AndHoratiu/proiect-scia/README.md

Analog Signal Processing System
General Description:
This project focuses on the design, simulation, and physical implementation of a complex electronic system intended for analog signal conditioning. The system is structured into four functional stages built using OP482 precision operational amplifiers.
System Architecture:
Stage 1: Inverting Amplifier with DC Compensation – Provides a linear gain of 7 and allows DC offset voltage adjustment via a potentiometer.
Stage 2: Sallen-Key Band-Pass Filter – Designed for a center frequency of 1 kHz, with a quality factor Q.
Stage 3: Programmable Gain Amplifier (PGA) – Allows gain adjustment between -1 dB and 8 dB (3 dB resolution) via analog switches.
Stage 4: Negative Peak Detector – A precision rectifier configuration with a linear gain of 1 used to extract the minimum value of the signal.
