AndHoratiu/proiect-scia/PROIECT SCIA.pdf

Instituția: Universitatea Tehnică Din Cluj Napoca
Facultatea: Facultatea de Electronică, Telecomunicații și Tehnologia Informației Disciplina: Sisteme cu Circuite Integrate Analogice (SCIA)

## PROIECT SCIA

Student: ANDRONE HORAȚIU GLIGOR

## TEMATICA PROIECTULUI

Proiect are ca scop realizarea și analiza unui sistem electronic bazat pe sisteme cu circuite integrate analogice (SCIA), destinat prelucrării unui semnal electric analogic, utilizând amplificatoare operaționale și circuite electronice.

Sistemul este structurat în patru etaje funcționale, realizate cu amplificatoare operaționale, fiecare având parametri electrici specifici. Proiectul analizează etapele de prelucrare a semnalului analogic, incluzând condiționarea, filtrarea activă, amplificarea cu câștig selectabil și redresarea de precizie, evidențiind rolul circuitelor
integrate | analogice | în | aplicațiile | de | prelucrare | a | semnalelor.

Specificații generale

- Sursa de semnal – single ended
- Amplitudine minimă: 199mV
- Amplitudine maximă: 561mV

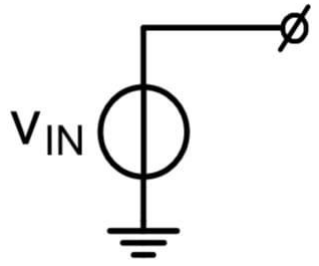
[picture p1: figure]

- Etaj 1: AO + compensare DC V-V – Amplificator inversor
- Căștig liniar: 7
- Rin_min: 1 kOhm
- Reglaj Out_DC: DA

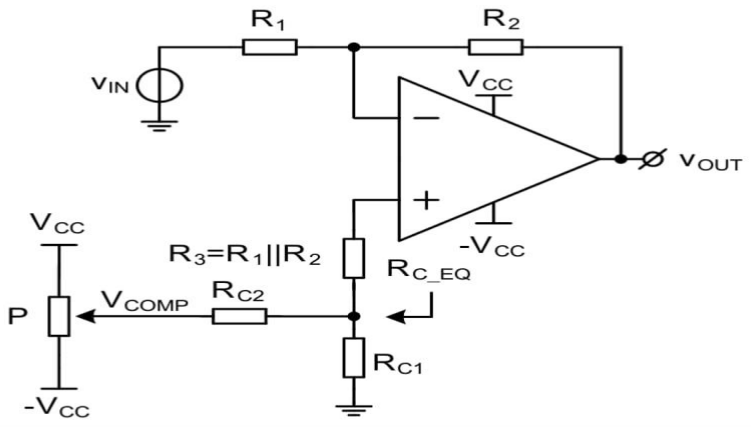
[picture p2: figure]

- Etaj 2: Filtru Trece-Banda Sallen-Key
- Câștig liniar: 1
- Rin_min: 750 ohm
- Banda: 1 kHz
- Q: 0,707

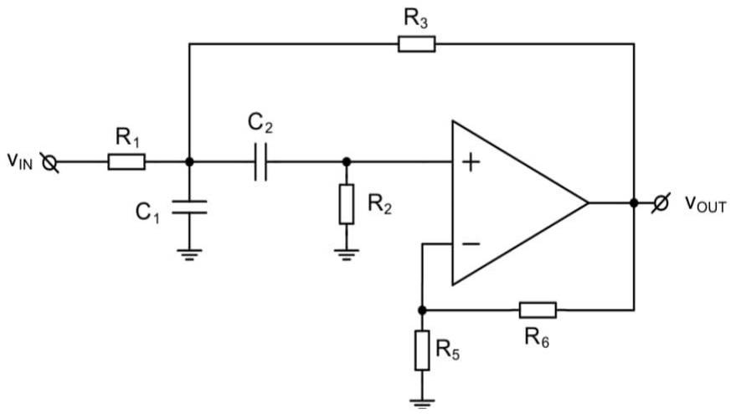
[picture p3: figure]

- Etaj 3: Amplificator cu câștig reglabil prin comutatoare
- Câștig minim: -1 dB
- Rezoluție: 3dB
- Număr pași: 4
- Câștig maxim: 8 dB
- Rin_min: 3 kOhm

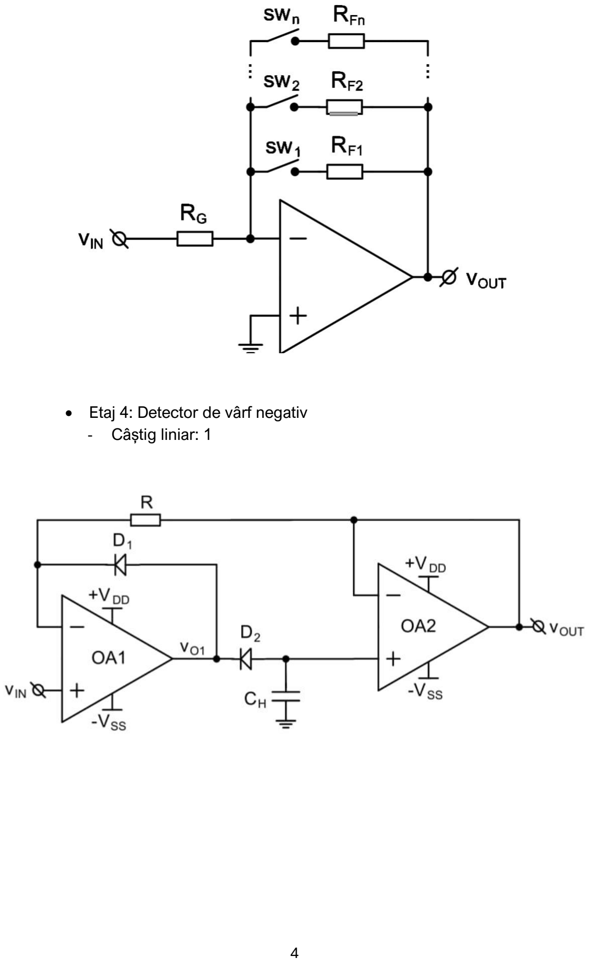
[picture p4: page 4]

- Etaj 4: Detector de vârf negativ
- Câștig liniar: 1

- Amplificator operational: OP482

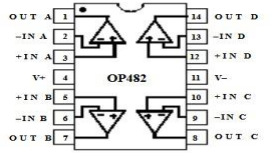
[picture p5: figure]

https://www.alldatasheet.com/html-pdf/49049/AD/OP482/43/2/OP482.html

## Dimensionarea etajelor

- Etaj 1 – dimensionare:

Av = −

R2
R1

= 7

R1 = 10kΩ

R2 = |Av

| ⋅ R1 = 7 ⋅ 10kΩ = 70kΩ

R3 = R1 ∥ R2 =

R1

⋅ R2
R1 + R2

= 8,75kΩ

V+ = VCOMP ⋅

RC1
RC1 + RC2

Vout = −

R2
R1

⋅ Vin + (1 +

R2
R1

) ⋅ V +

⇒ RC1 = 1kΩ RC2 = 220kΩ

- Etaj 2 – dimensionare:

Conform:

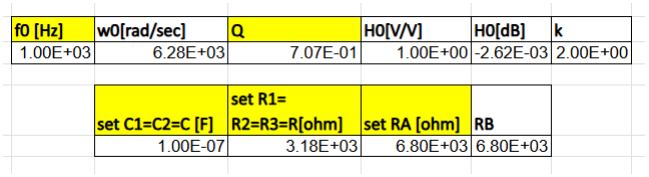
[picture p6: figure]

HBP =

VoutBP
Vin =

(s ⋅ wz)
s

2 + s ⋅

wp
Q

⋅ wp

2

R1 = R2 = R3 = 3,18kΩ

RA = RB = 6,8kΩ

- Etaj 3 – dimensionare:
SW 1 | SW 2 | SW3 | SW 4 | RG | RF | AV_liniar
1 | 0 | 0 | 0 | RG | R4 | 0,891
0 | 1 | 0 | 0 | RG | R3 | 1,259
0 | 0 | 1 | 0 | RG | R2 | 1,778
0 | 0 | 0 | 1 | RG | R1 | 2,512

AdB = [−1, 2, 5, 8]

AVliniar = 10

AdB
20

AV =

RG
RF

⇒ RF = AV ⋅ RG

Aleg RG = 3,3kΩ

RF1 = 2,94kΩ | RF2 = 4,15kΩ | RF3 = 5,67kΩ | RF4 = 8,29kΩ
- Etaj 4 – dimensionare:

Vin > 0 ⇒ VOA1 ↑ VDD ⇒ D1 ON, D2 OFF ⇒ VO = −

R2
R1

⋅ Vin
Vin < 0 ⇒ VOA2 ↓ − VSS ⇒ D1 OFF, D2 ON ⇒ VO = Vin

R = 10kΩ C = 100nF

## Caracterizare etajelor

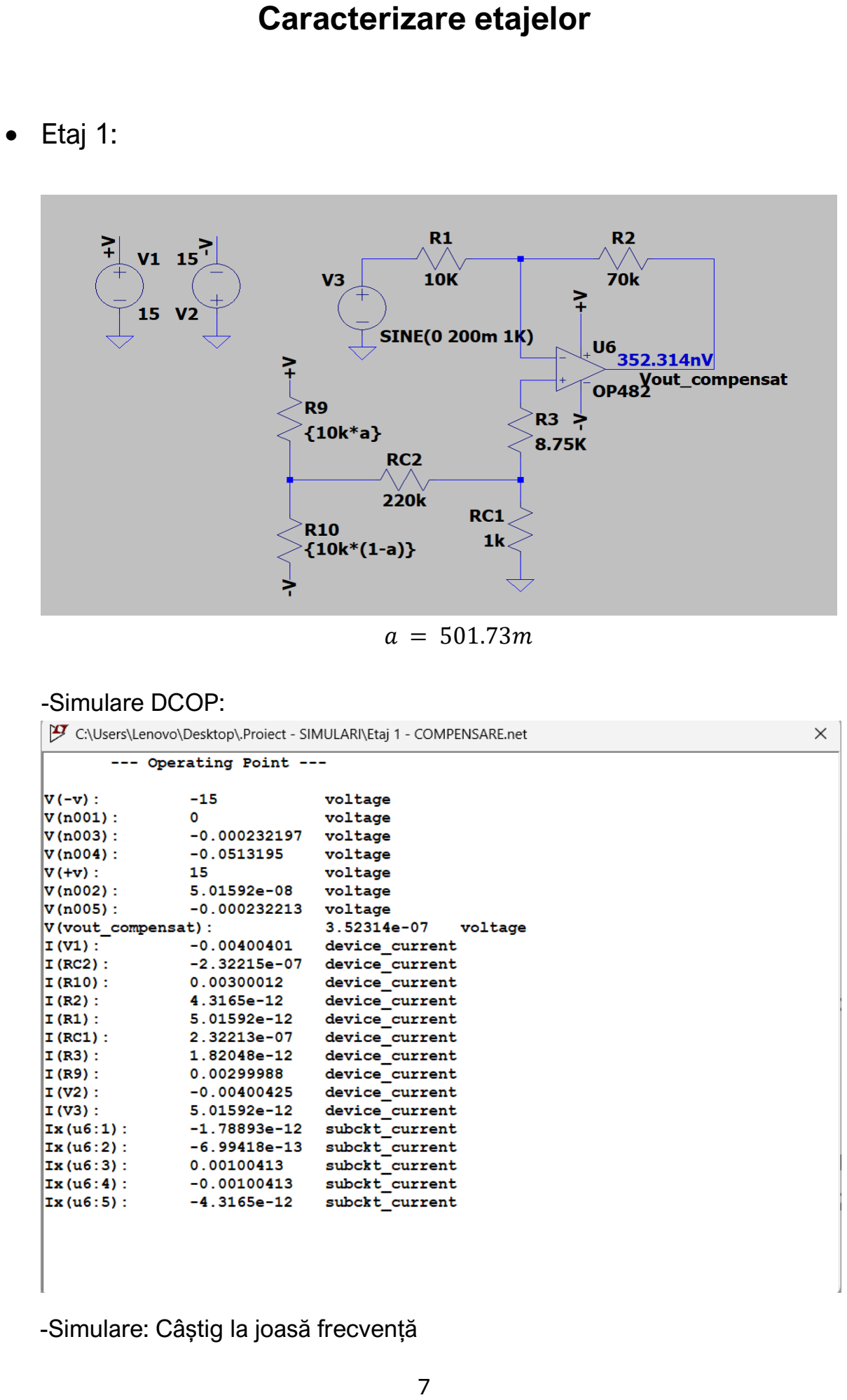
[picture p7: page 7]

- Etaj 1:

a = 501.73m

-Simulare DCOP:

-Simulare: Câștig la joasă frecvență

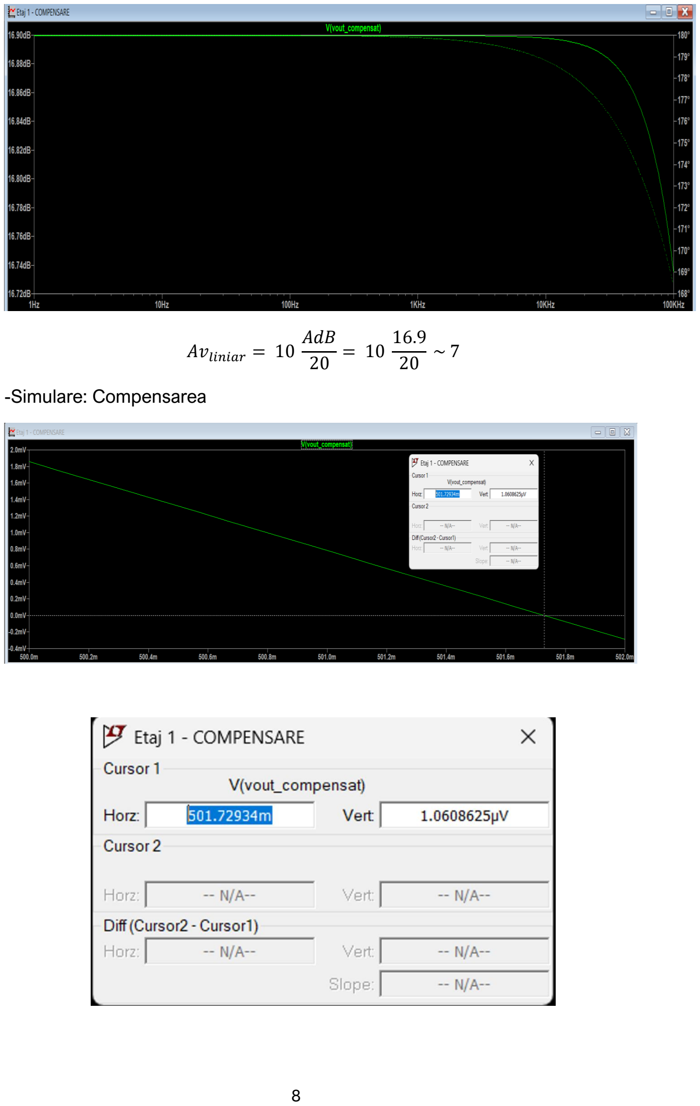
[picture p8: page 8]

Avliniar = 10

AdB
20 = 10

16.9
20 ~ 7

-Simulare: Compensarea

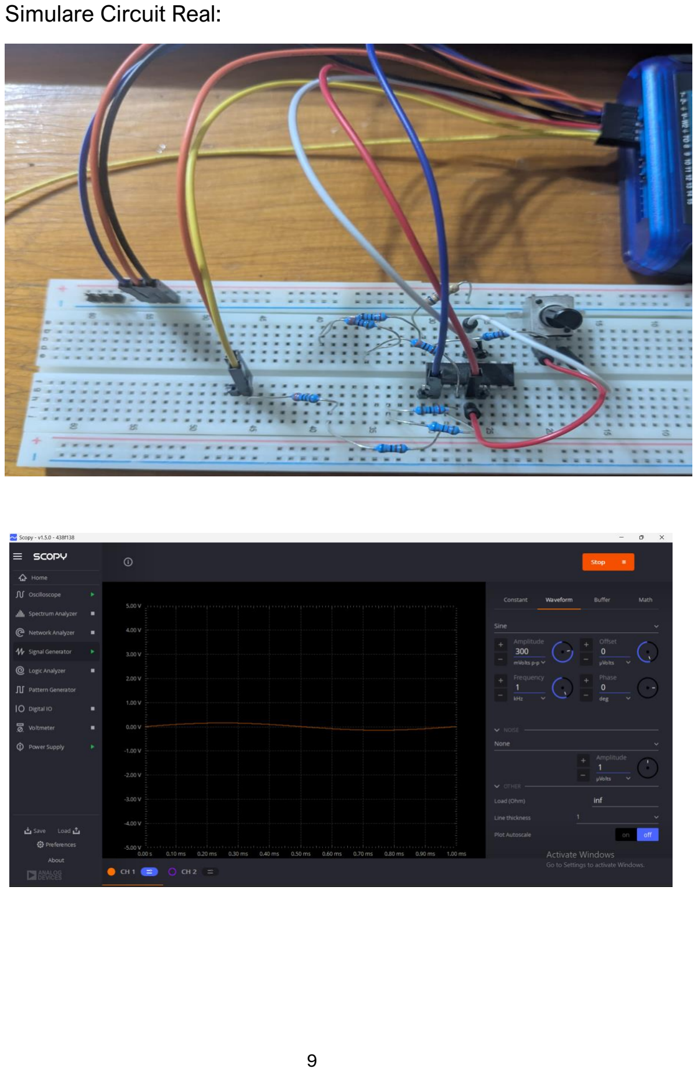
[picture p9: page 9]

Simulare Circuit Real:

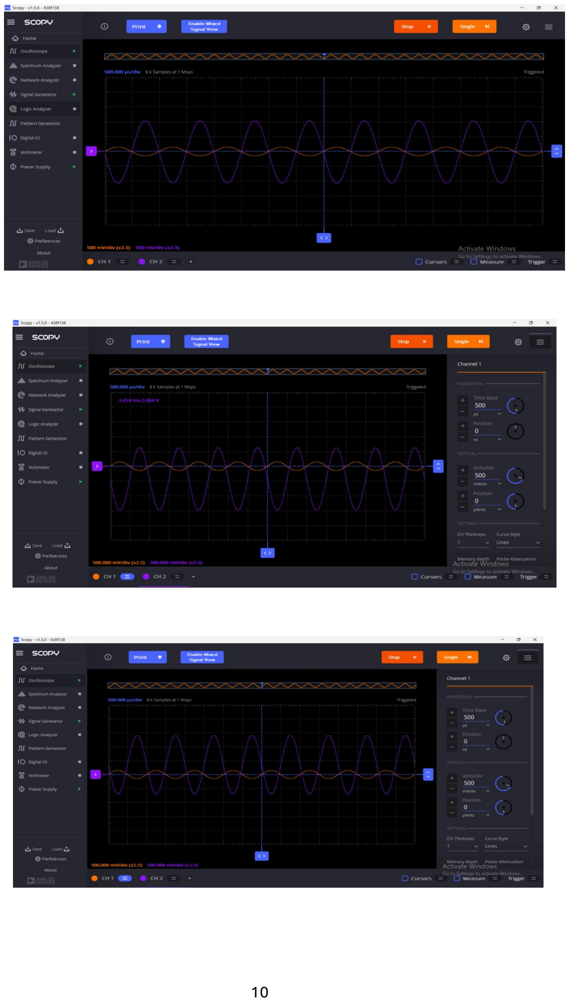
[picture p10: page 10]
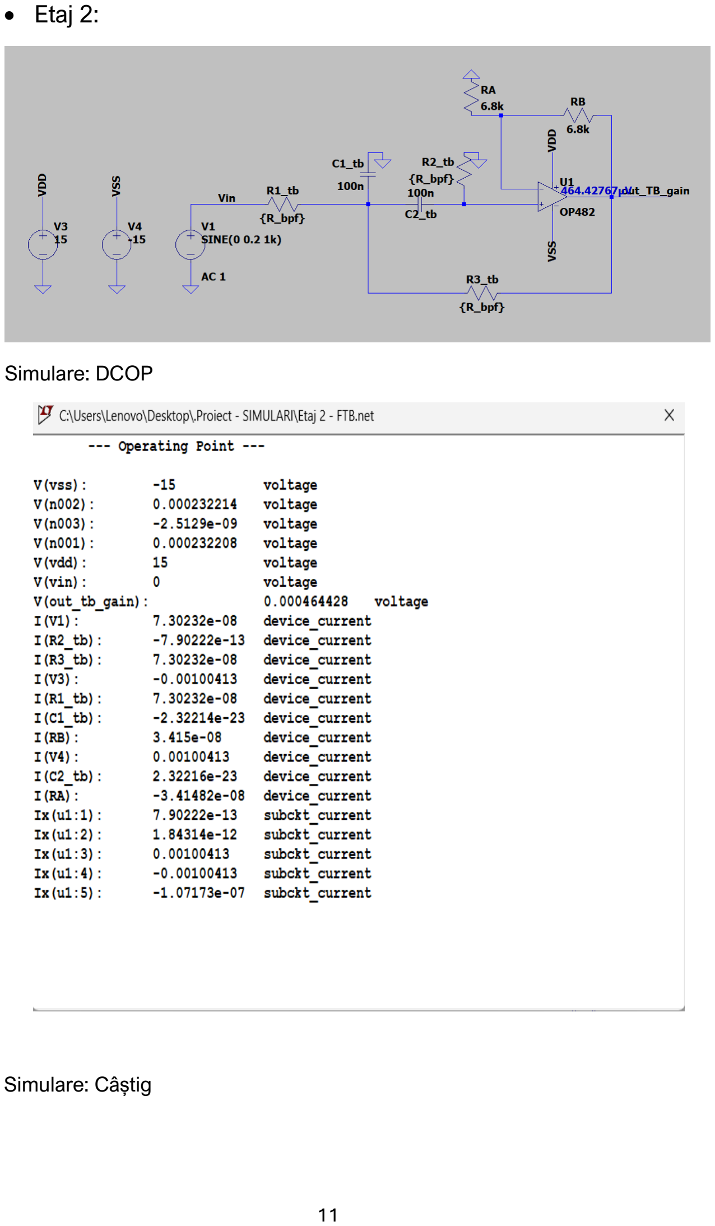
[picture p11: page 11]

- Etaj 2:

Simulare: DCOP

Simulare: Câștig

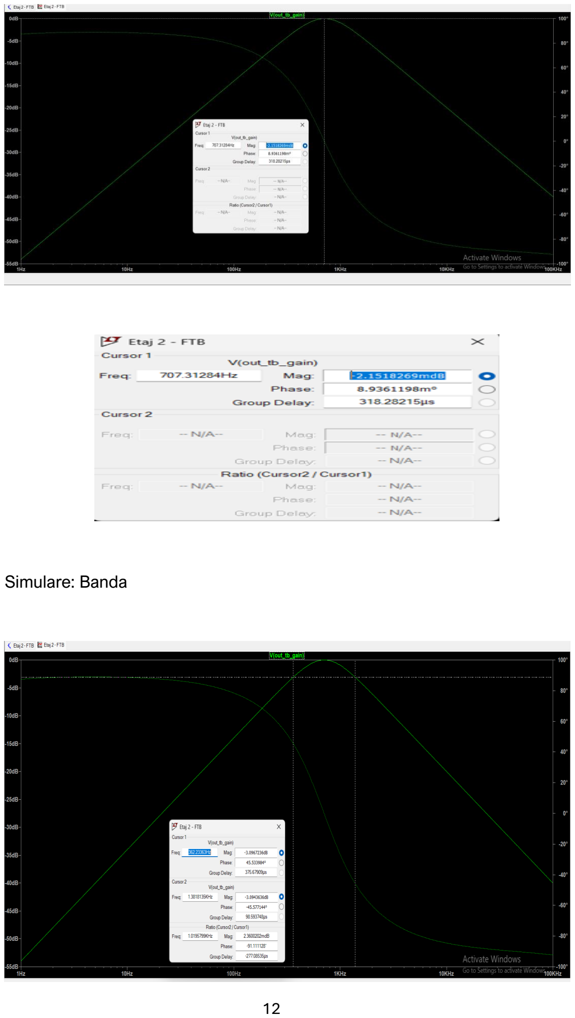
[picture p12: page 12]

Simulare: Banda

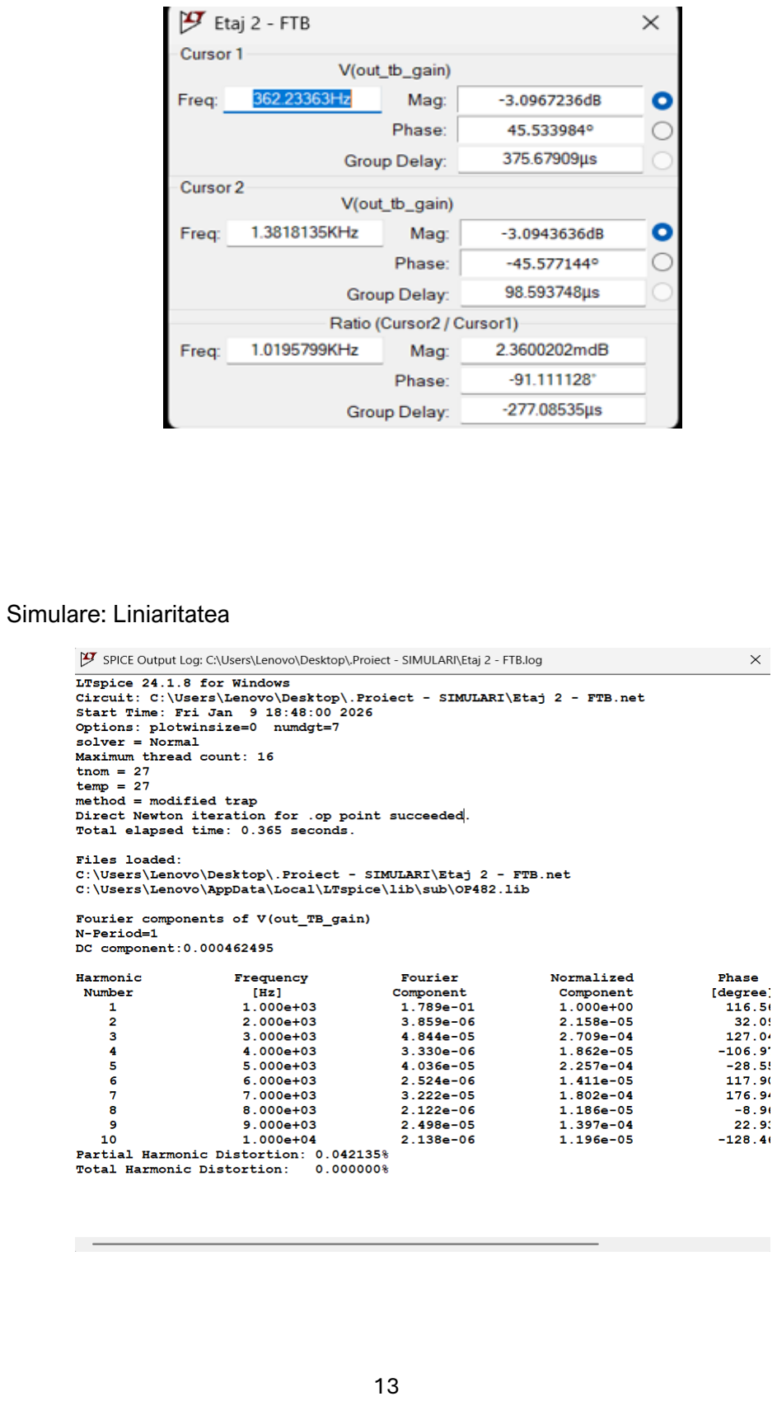
[picture p13: page 13]

Simulare: Liniaritatea

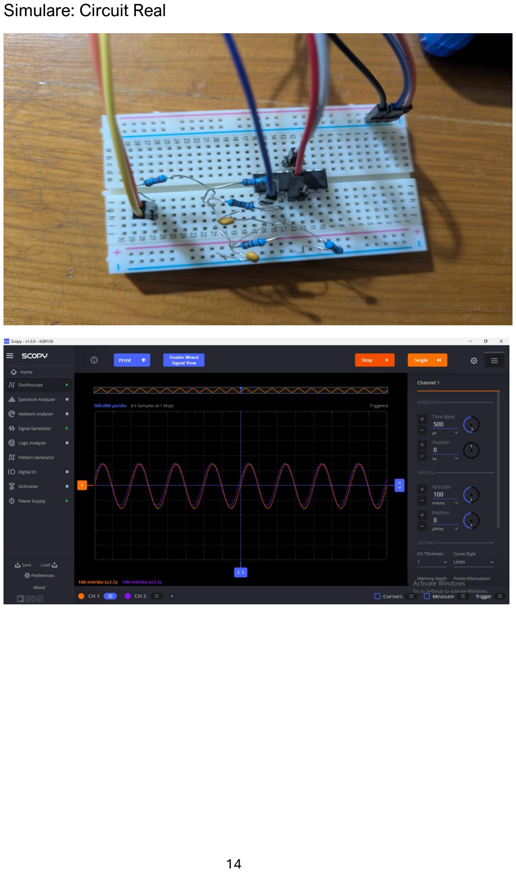
[picture p14: page 14]

Simulare: Circuit Real

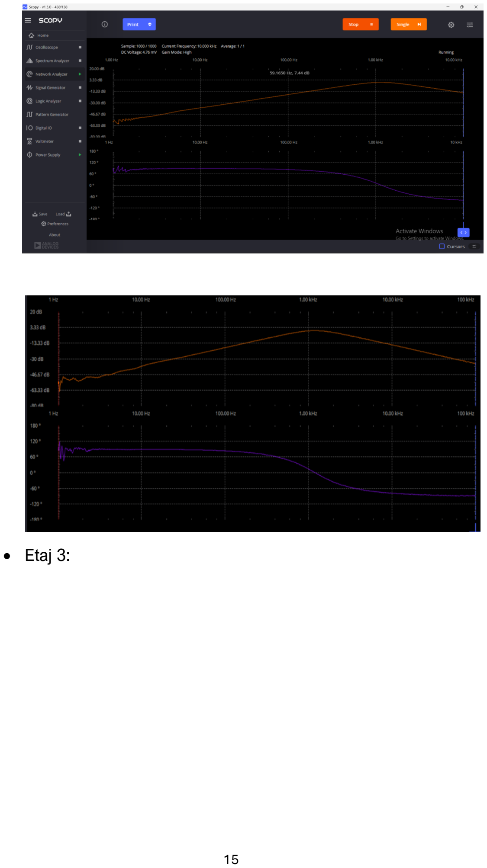
[picture p15: page 15]

- Etaj 3:

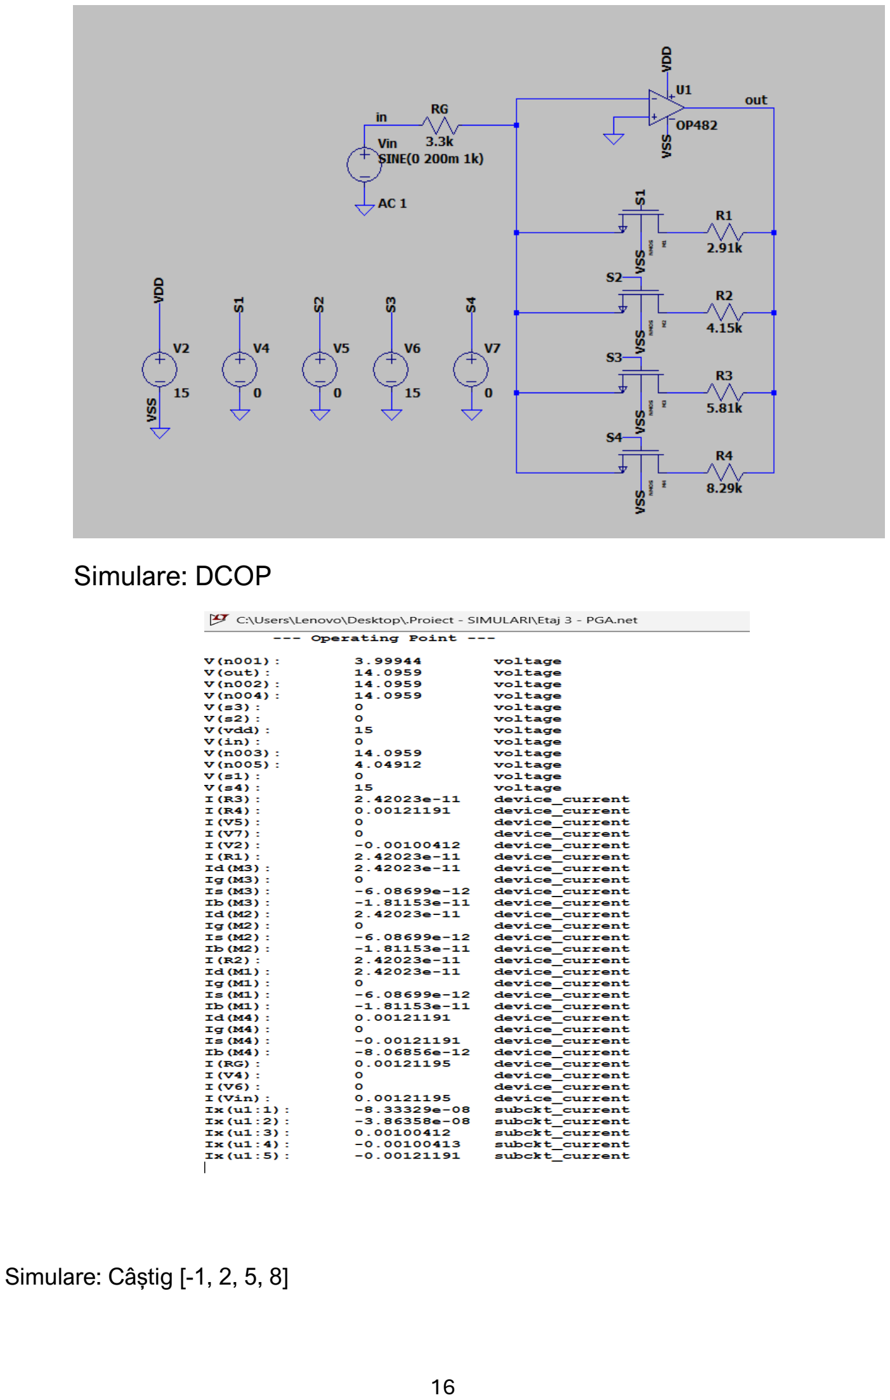
[picture p16: page 16]

Simulare: DCOP

Simulare: Câștig [-1, 2, 5, 8]

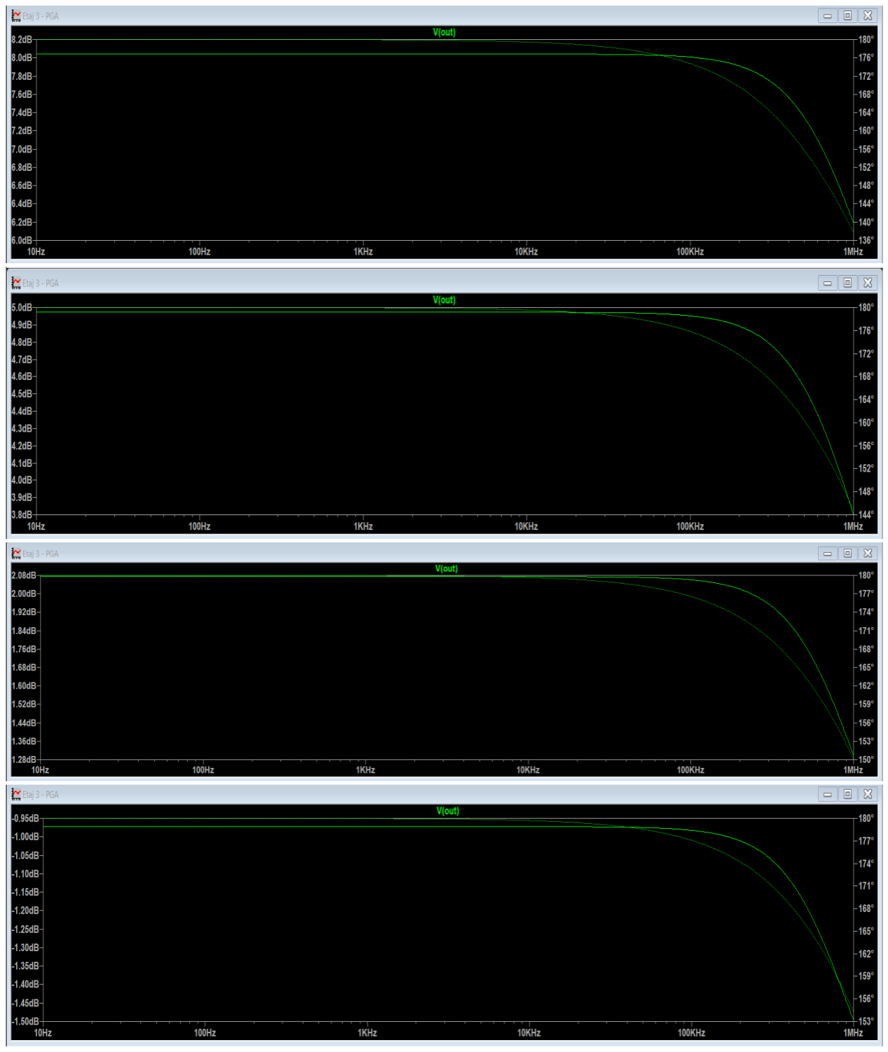
[picture p17: figure]

Simulare: Liniariate

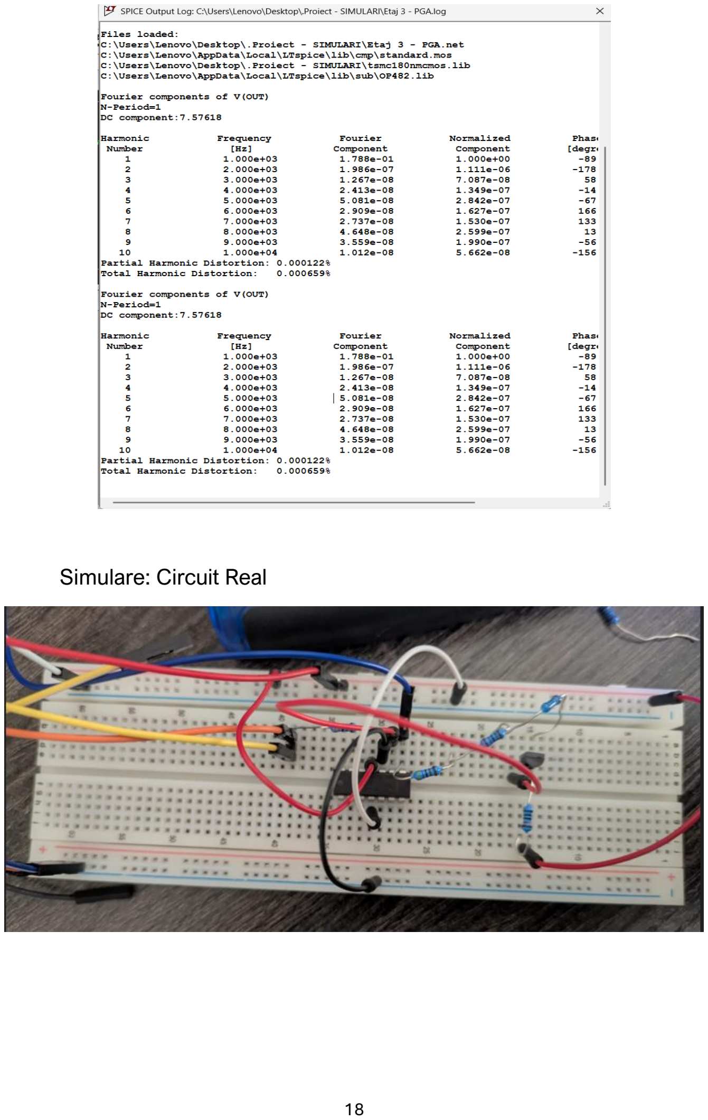
[picture p18: page 18]

Simulare: Circuit Real

### Simulare: Câștig

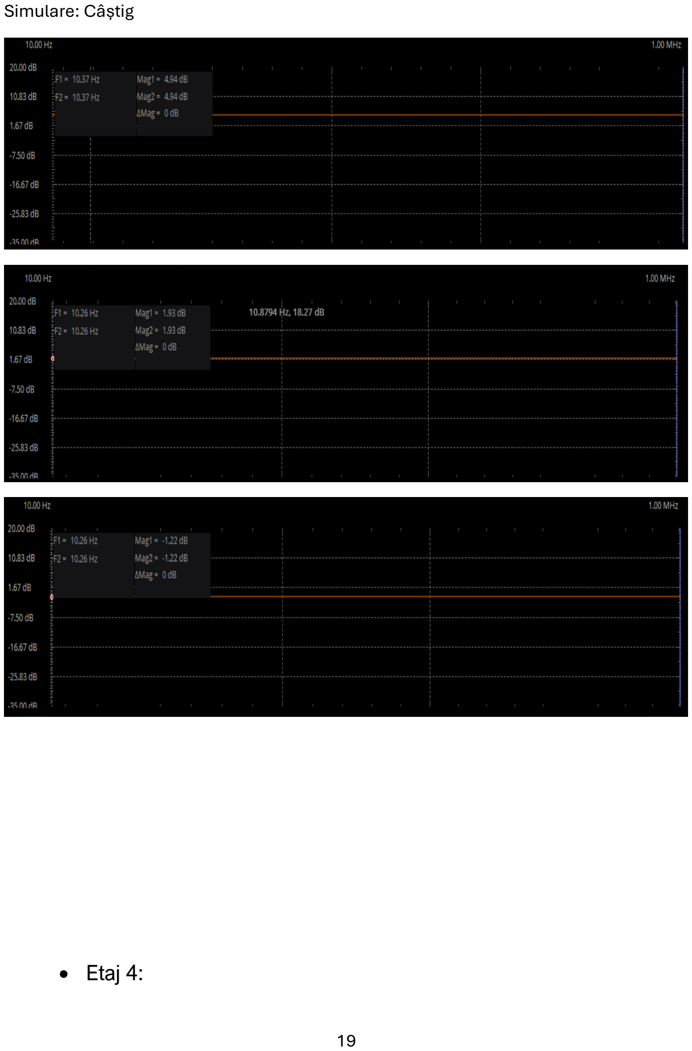
[picture p19: page 19]

- Etaj 4:

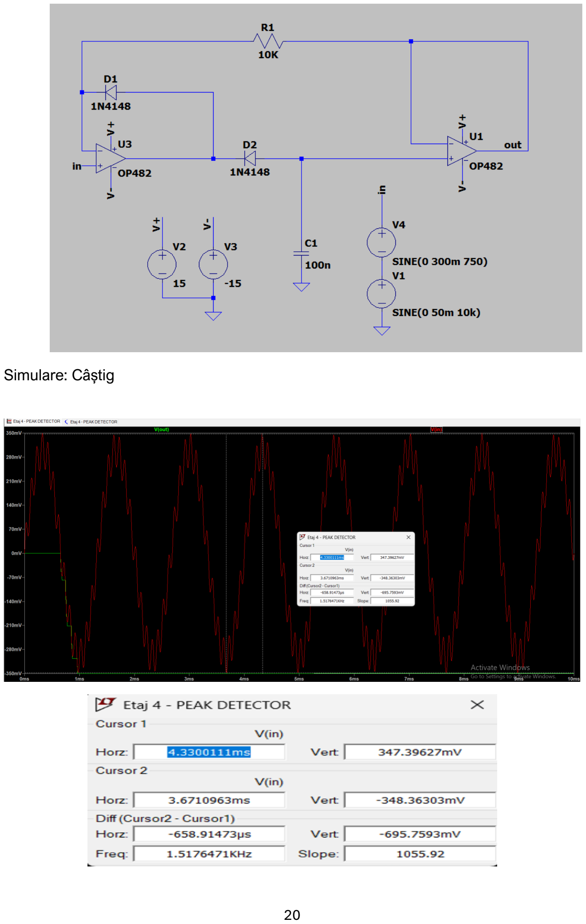
[picture p20: page 20]

Simulare: Câștig

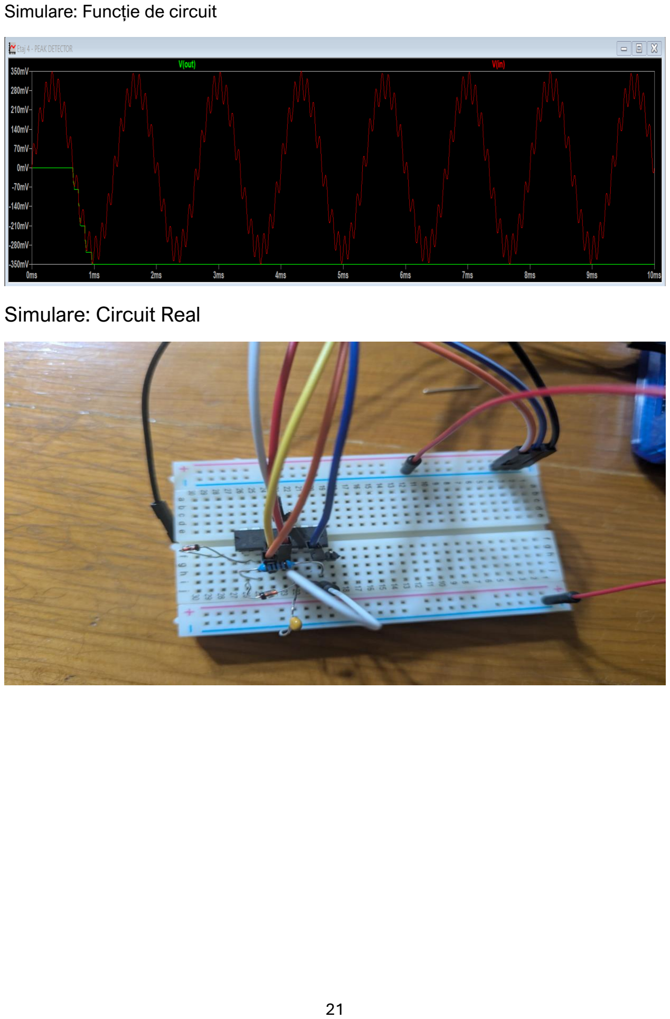
[picture p21: page 21]

Simulare: Funcție de circuit

Simulare: Circuit Real

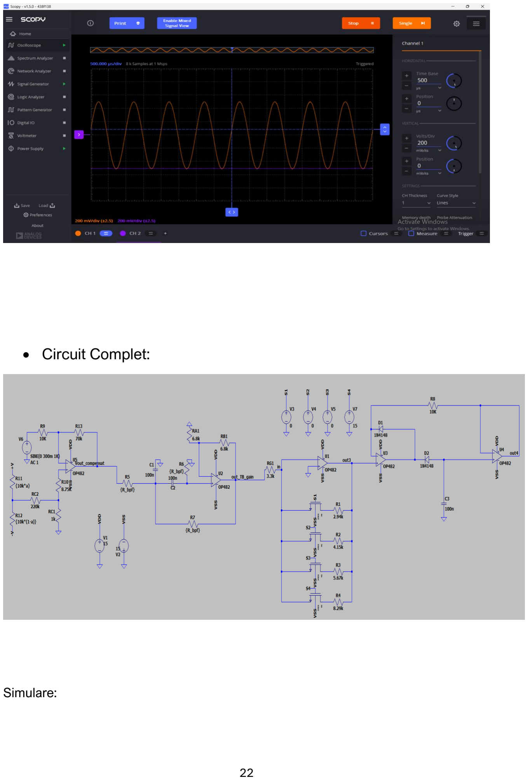
[picture p22: page 22]

- Circuit Complet:

Simulare:

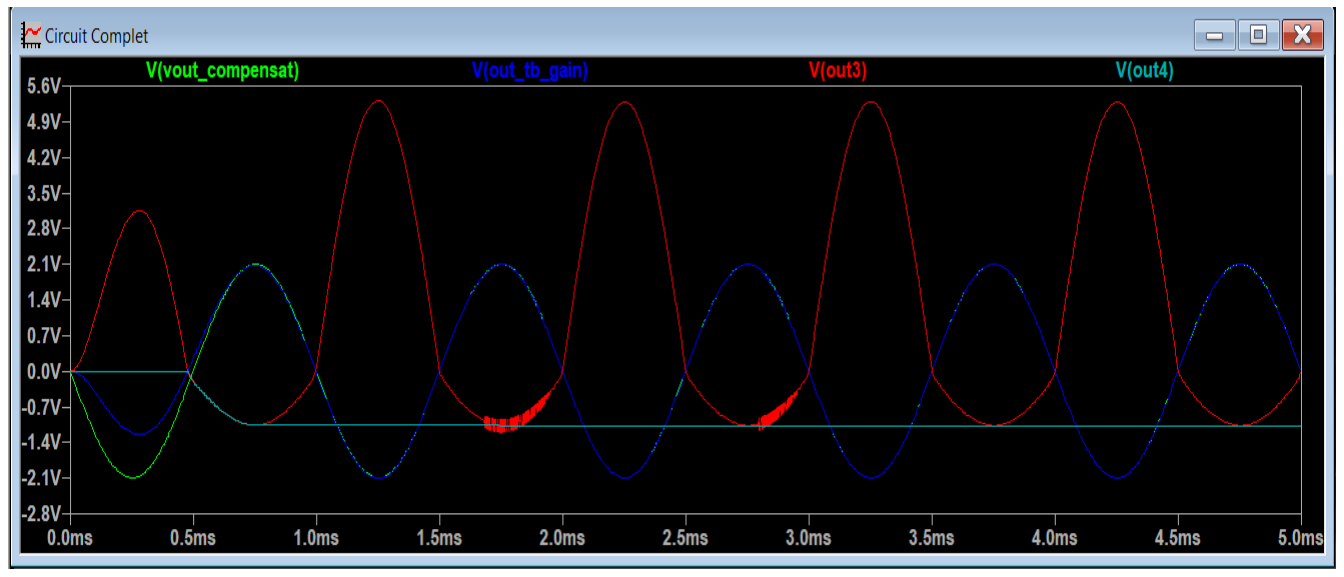
[picture p23: figure]

## Verificarea și caracterizarea interfeței analogice

- Funcționare logică:

Semnalul de intrare va trece prin fiecare etaj, acesta va fi supus la modificari.

-Etaj 1: Vin minim = 199mV -> Vout minim AO = 1,393V

Vin maxim = 561mV -> Vout maxim AO = 3,923V

-Etaj 2: Filtrarea

-Etaj 3:

*pentru câștig Vout etaj 1 minim

Vout minim PGA => 1,393 * 2,51 = 3,499V

Vout maxim PGA => 3,923 * 2,51 = 9,854V

*pentru câștig Vout etaj 1 maxim

Vout minim PGA => 1,393 * 0,891 = 1,241V

Vout maxim PGA => 3,923 * 0,891 = 3,495V

+alte ieșiri in funcție de valorile alese.

-Etaj 4: Redresarea

- Verificarea punctului de saturație

Interfața funcționează în regim liniar deoarece amplitudinea maximă la ieșire (aprox. 9.84V în cazul câștigului maxim) se află sub pragul de saturare al amplificatoarelor operaționale, asigurând o distorsiune minimă

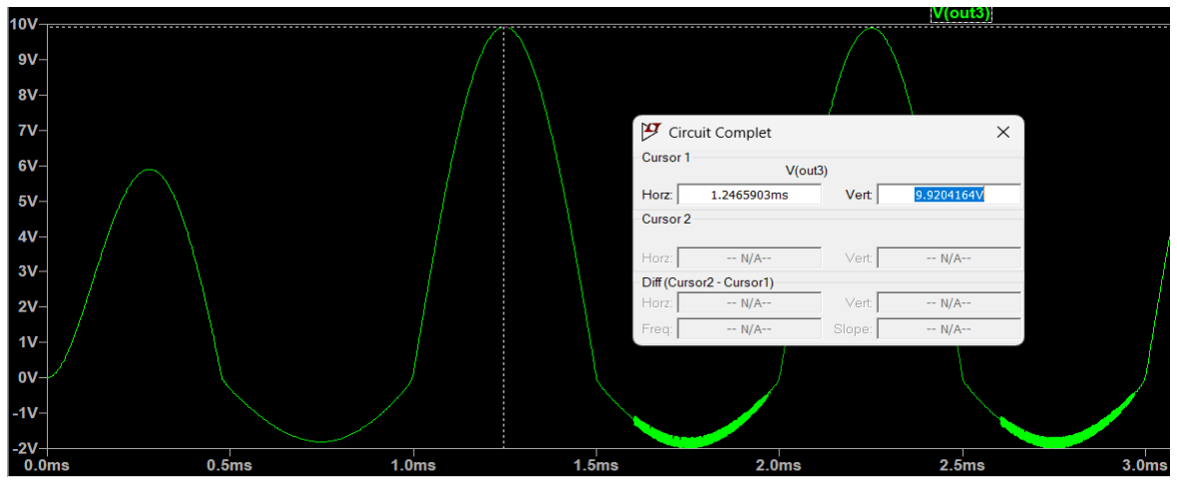
[picture p24: figure]

- Analiza stabilității

S-a observat o degradare a stabilității buclei de reacție odată cu creșterea amplitudinii semnalului; mai exact, peste 300mV, capacitățile parazite ale switch-urilor NMOS provoacă instabilitate dinamică. Acest comportament afectează direct precizia conversiei AC-DC, generând un offset nedorit la ieșirea finală. In timp ieșirea se va repera.

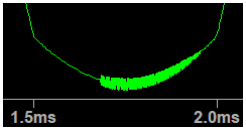
[picture p25: figure]

Comparare rezultate simulari - măsurători

ETAJ 1

VOUT compensat | SIMULĂRI | MĂSURĂTORI
199 mV | 1,393 V | 1,389 V
561 mV | 3,926 V | 3,921 V

ETAJ 3

CÂȘTIG - 561mV | SIMULĂRI | MĂSURĂTORI
-1 dB | 3,529 V | 3,47 V
2 dB | 4,967 V | 4,89 V
5 dB | 6,797 V | 6,71 V
8 dB | 9,881 V | 9,81 V
CÂȘTIG - 199mV | SIMULĂRI | MĂSURĂTORI
-1 dB | 1,256 V | 1,249 V
2 dB | 1,776 V | 1,71 V
5 dB | 2,411 V | 2,36 V
8 dB | 3,519 V | 3,45 V

## Concluzii

Proiectul a vizat realizarea unui sistem electronic complex structurat în patru etaje funcționale, utilizând amplificatoare operaționale de precizie tip OP482. În urma etapelor de proiectare, simulare și testare pe circuit real.

Primul etaj a asigurat cu succes amplificarea cu un câștig liniar de 7, integrând un mecanism eficient de compensare a tensiunii de offset prin reglaj potențiometric.

Etajul al doilea a demonstrat o selectivitate ridicată, funcționând ca un filtru trece-bandă cu o frecvență centrală de 1kHz și un factor de calitate Q = 0.707.

Etajul al treilea consta in implementarea amplificatorului cu câștig variabil a permis ajustarea amplitudinii semnalului în patru pași (între -1dB si 8dB), cu o rezoluție de 3dB, oferind versatilitate sistemului în funcție de amplitudinea sursei de semnal.

Etajul al patrulea a asigurat cu succes funcția de detector de vârf negativ, utilizând o configurație de redresor de precizie cu câștig liniar de 1 pentru a extrage valoarea minimă a semnalului.
În concluzie, obiectivele proiectului au fost îndeplinite, realizându-se un sistem capabil de condiționare, filtrare, amplificare selectabilă și redresare de precizie a semnalelor analogice.
