AndHoratiu/proiect-scia/circuit.png

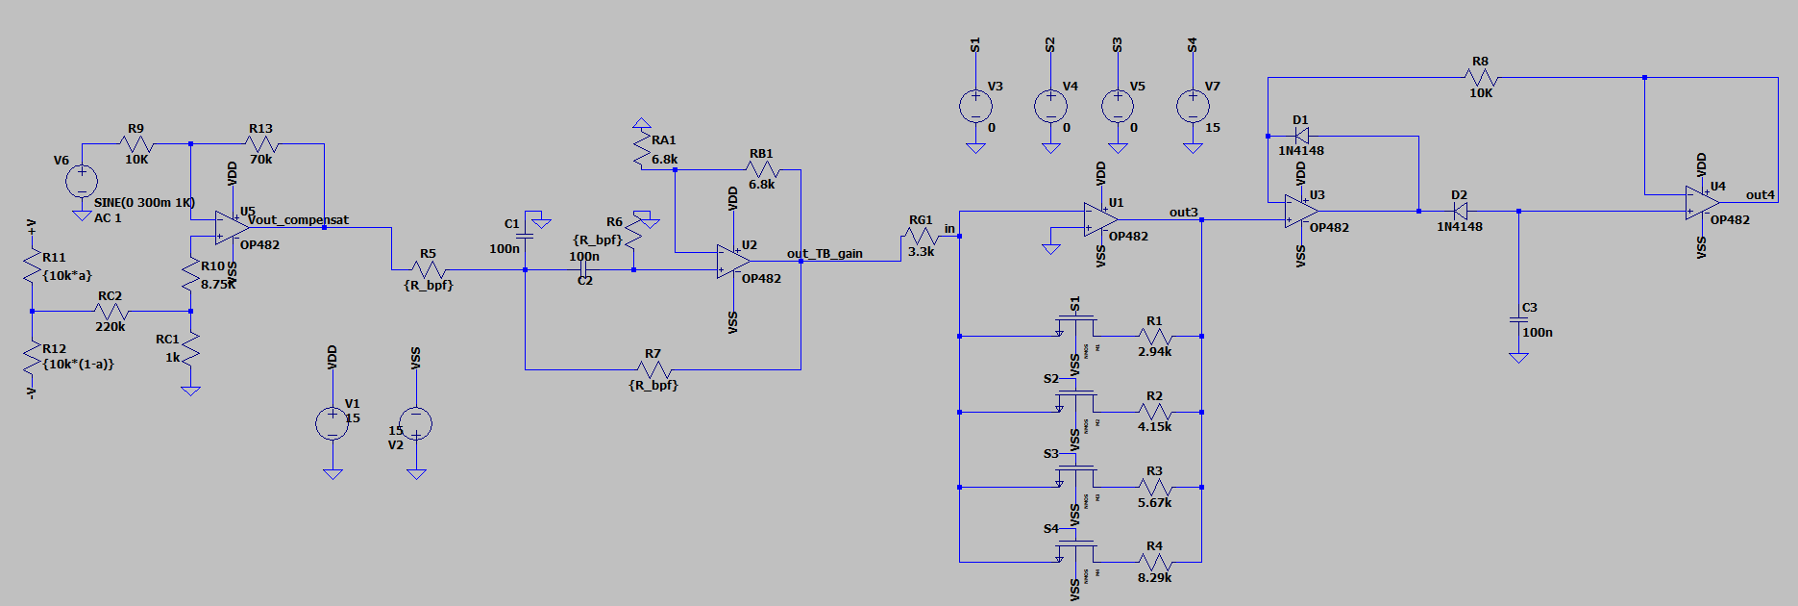
circuit.png
