AndHoratiu/proiect-scia/Circuit Complet.asc

C1: cap; 100n
C2: cap; 100n
C3: cap; 100n
D1: diode; 1N4148
D2: diode; 1N4148
M1: nmosb; l=180n w=20u ad=3.6p as=3.6p pd=40.4u ps=40.4u
M2: nmosb; l=180n w=20u ad=3.6p as=3.6p pd=40.4u ps=40.4u
M3: nmosb; l=180n w=20u ad=3.6p as=3.6p pd=40.4u ps=40.4u
M4: nmosb; l=180n w=20u ad=3.6p as=3.6p pd=40.4u ps=40.4u
R1: res; 2.94k
R2: res; 4.15k
R3: res; 5.67k
R4: res; 8.29k
R5: res; {R_bpf}
R6: res; {R_bpf}
R7: res; {R_bpf}
R8: res; 10K
R9: res; 10K
R10: res; 8.75K
R11: res; {10k*a}
R12: res; {10k*(1-a)}
R13: res; 70k
RA1: res; 6.8k
RB1: res; 6.8k
RC1: res; 1k
RC2: res; 220k
RG1: res; 3.3k
U1: OP482
U2: OP482
U3: OP482
U4: OP482
U5: OP482
V1: voltage; 15
V2: voltage; 15
V3: voltage; 0
V4: voltage; 0
V5: voltage; 0
V6: voltage; SINE(0 561m 1K); AC 1
V7: voltage; 15
Named nets: S1, S2, S3, S4, VSS, out3, VDD, 0, out4, Vout_compensat, +V, -V, in, out_TB_gain
.tran 5ms
.param gbwao=10g
.param SR=10Meg
.param R_bpf=2.25k
.param a=501.73m
.FOUR 1khz 10 V(out_TB_gain)
.OPTIONS plotwinsize=0
.OPTIONS numdgt=7
.lib tsmc180nmcmos.lib
.meas AC Rin FIND Rintrare() AT 1
.func Rintrare() V(in)/I(V6)
.ac dec 100 10 10khz
.op
