AndHoratiu/proiect-scia/Etaj 1 - COMPENSARE.asc

R1: res; 10K
R2: res; 70k
R3: res; 8.75K
R9: res; {10k*a}
R10: res; {10k*(1-a)}
RC1: res; 1k
RC2: res; 220k
U6: OP482
V1: voltage; 15
V2: voltage; 15
V3: voltage; SINE(0 200m 1K); AC 1
Named nets: 0, +V, -V, Vout_compensat
.param a=501.73m
;tran 5ms
.op
.step param a 0.500 0.502 0.0001
.ac dec 100 1 1meg
