AndHoratiu/proiect-scia/Etaj 2 - FTB.asc

C1_tb: cap; 100n
C2_tb: cap; 100n
R1_tb: res; {R_bpf}
R2_tb: res; {R_bpf}
R3_tb: res; {R_bpf}
RA: res; 6.8k
RB: res; 6.8k
U1: OP482
V1: voltage; SINE(0 0.2 1k); AC 1
V3: voltage; 15
V4: voltage; -15
Named nets: 0, VDD, VSS, out_TB_gain, Vin
.ac dec 1000 1 100k
.op
.tran 10m
.param a=10k
.param gbwao=10g
.param SR=10Meg
.FOUR 1khz 10 V(out_TB_gain)
.OPTIONS plotwinsize=0
To disable compression
.OPTIONS numdgt=7
.step param SR list 0.1Meg 0.2Meg 0.3Meg 0.4Meg
.param R_bpf=3.18k
