AndHoratiu/proiect-scia/Etaj 3 - PGA.asc

M1: nmosb; l=180n w=20u ad=3.6p as=3.6p pd=40.4u ps=40.4u
M2: nmosb; l=180n w=20u ad=3.6p as=3.6p pd=40.4u ps=40.4u
M3: nmosb; l=180n w=20u ad=3.6p as=3.6p pd=40.4u ps=40.4u
M4: nmosb; l=180n w=20u ad=3.6p as=3.6p pd=40.4u ps=40.4u
R1: res; 2.91k
R2: res; 4.15k
R3: res; 5.81k
R4: res; 8.29k
RG: res; 3.3k
U1: OP482
V2: voltage; 15
V4: voltage; 15
V5: voltage; 0
V6: voltage; 0
V7: voltage; 0
Vin: voltage; SINE(0 200m 1k); AC 1
Named nets: 0, VDD, VSS, S1, S2, S3, S4, out, in
.ac dec 1000 10 1Meg
.op
.tran 0 10m 0 100n
.FOUR 1khz 10 V(OUT)
.OPTIONS plotwinsize=0
To disable compression
.OPTIONS numdgt=7
To switch to double precision math
on dependent variables
.lib tsmc180nmcmos.lib
;dc Vin 0 1.8 1m
.meas AC Rin FIND Rintrare() AT 1
.func Rintrare() V(in)/I(Vin)
.FOUR 1khz 10 V(OUT)
.OPTIONS plotwinsize=0
To disable compression
.OPTIONS numdgt=7
