AndHoratiu/proiect-scia/Etaj 4 - PEAK DETECTOR.asc

C1: cap; 100n
D1: diode; 1N4148
D2: diode; 1N4148
R1: res; 10K
U1: OP482
U3: OP482
V1: voltage; SINE(0 50m 10k)
V2: voltage; 15
V3: voltage; -15
V4: voltage; SINE(0 300m 750)
Named nets: 0, V+, V-, in, out
.tran 10ms
.op
.dc V4 -0.5 0.5 0.01
.options skipdc
